Vuoti/PaceBreaker/README.md

# Eine interaktive Schnitzeljagd - PaceBreaker

Produktvisualisierung

## Das Konzept
Dieses Projekt ist im Rahmen des sechsten Semesters im Studiengang Interactive Media Design, im Sommersemester 2018. Das Team, bestehend aus Nadja Lipphardt, Lisa Brandt, Lisa Rosendorff, Niklas Danz und André Fritzinger hat sich in diesem Zeitraum intensiv mit dem Thema “Ambient Intelligence Spaces” auseinandergesetzt.<br>

Das im folgenden vorgestellte Projekt widmet sich der Prävention von Stereotypien bei Tieren in Gefangenschaft. Es handelt sich dabei um Verhaltensstörungen, welche aufgrund eines eingeschränkten und nicht-natürlichen Lebensraums auftreten können. Eine entscheidende Rolle scheint dabei die kognitive Auslastung zu spielen, sowie die Möglichkeit, arttypischen Verhalten nachzugehen.<br>

Da sich besonders Zoos häufig mit diesem Problem konfrontiert sehen, hat sich das Team auf diesen Nutzungsbereich festgelegt. Ziel des Projektes stellt die Dokumentierung und präventive Bekämpfung von Stereotypien bei Raubtieren, insbesondere Fossa, da.<br>
Erreicht werden soll dies durch ein interaktives System welches, im Tiergehege installiert, die Jagd auf einen Vogel (oder ein anderes Futtertier) simuliert. Drahtlos verbundene Stationen mit Lautsprechern geben hierfür Tiergeräusche wieder, denen das Raubtier folgen kann. Erreicht das Tier eine der Stationen, registriert diese die Näherung und hört auf den Sound zu spielen. Nun beginnt ein anderer Lautsprecher Tiergeräusche abzuspielen.
Diese Technik ermutigt das Tier, kreuz und quer durch das Gehege zu jagen bis es schließlich bei der letzten Station - dem Feeder - angelangt. Hier zahlt sich schließlich die aufgebrachte Mühe, in Form einer Fütterung (mit frischem Fleisch) für das Tier aus.<br>
Parallel zeichnet eine am Gehegerand angebrachte Kamera den gesamten Nutzungs- und Bewegungsverlauf des Tieres auf und erstellt daraus eine Heatmap. Anhand dieser lässt sich im Nachhinein objektiv feststellen wann und wo Stereotypien aufgetreten sind.<br>

Das Projekt verbindet die Verbesserung der Lebensbedingungen von Tieren in Gefangenschaft - genannt Enrichment - mit einer zuverlässigen Dokumentationsmethode für stereotypisches Pacing. Gerade für letzteres ist noch kein kommerziell erwerbliches Produkt für Zoos auf dem Markt.<br> 
Anders als bei den meisten Enrichment Angeboten fördert die Lösung aktiv das natürliche Jagdverhalten von Raubtieren und bezieht hierbei den gesamten verfügbaren Raum um das Tier mit ein. Darüber hinaus ist es für den Pfleger flexibel konfigurier- und anpassbar und kann durch eine Teil-Automatisierung des Fütterungsprozesses für eine Entlastung seiner Stelle dienen.<br>
