Vuoti/PaceBreaker/(commit log)

2018-07-08 Lockstation
    Lockstation mit Multiwlan, Mp3 Stream und PIR Sensor
2018-07-09 Feeder Code und README
2018-07-09 Backend und Frontend Code hinzugefügt
2018-07-09 Tabelle gefixed in der Readme
